reyrg2021/rover-ua/entregables/Rover UA · Temuco 2026.pptx

## Vehículo autónomo con evasión de obstáculos

GUÍA PARA EL EQUIPO · CONGRESO TEMUCO 2026

Cómo funciona el auto, cómo se calibra y cómo se prueba para obtener los datos que prometimos en el resumen.

IV Congreso de Ingeniería Aplicada a la Industria Sustentable

Universidad Autónoma de Chile · Sede Temuco · 21 y 22 de octubre de 2026

Facultad de Ingeniería · Sede Santiago

Notes: Esta guía es para el equipo: explica el auto completo, versión reactiva (la del resumen) y versión con barrido (la mejora), y el protocolo de pruebas para llenar los datos que faltan en el resumen. Léanla entera antes de la próxima sesión de pruebas.

## Qué prometimos y qué datos faltan

LO QUE DICE EL RESUMEN ENVIADO

Lo que ya está escrito

- Vehículo a escala, bajo costo, de estudiantes de primer año
- ESP32 + L298N + 2 motores DC + servo de dirección + 3 HC-SR04
- Máquina de estados con tres zonas por distancia frontal
- Crítica: retrocede y avanza en arco "como al estacionar"
- Histéresis de 5 cm para no oscilar entre zonas

Lo que hay que medir (corchetes del resumen)

- [N] recorridos de un circuito de [X] m con [N] obstáculos
- [X] % de recorridos completados sin colisiones
- Tiempo promedio [X ± Y] segundos
- Costo de materiales [$X] CLP
- Dónde se concentraron las colisiones

El resumen describe la versión reactiva. Esa es la que se evalúa primero. El barrido y las demás mejoras se presentan como trabajo adicional, con sus propios datos.

Rover UA · Temuco 2026

2

Notes: Los corchetes del resumen son compromisos. Todo lo que sigue sirve para llenarlos con datos reales, no estimados.

## Arquitectura del hardware

CONSTRUCCIÓN

Cerebro

ESP32 sobre shield con regulador. Lee sensores, decide, mueve motores y servos, y sirve la página WiFi.

Tracción

Puente H L298N y dos motores DC traseros. Motor A = rueda derecha, motor B = rueda izquierda. PWM a 1 kHz.

Dirección

Servo estándar sobre las ruedas delanteras. Centro 100°, recorrido útil 78° a 117° (±17°).

Percepción

Tres HC-SR04: dos laterales fijos a ~45° y uno central montado sobre un micro servo que puede barrer ±45°.

Energía

Cuatro 18650 de 2600 mAh en dos packs de 7,4 V: uno para el L298N y motores, otro para el shield del ESP32.

Interfaz

El ESP32 crea su propia red WiFi. Un celular muestra sensores, mapa, cronómetro y botones de inicio y pausa.

Rover UA · Temuco 2026

3

Notes: Seis bloques. Cada estudiante debería poder explicar cualquiera de los seis en un minuto, con el auto en la mano.

## Mapa de conexiones del ESP32

CONSTRUCCIÓN

Elemento | Señal | GPIO
Motor A (derecha) | ENA · IN1 · IN2 | 25 · 26 · 27
Motor B (izquierda) | ENB · IN3 · IN4 | 33 · 32 · 19
Servo de dirección | señal | 18
Servo de barrido | señal | 23
HC-SR04 derecho | Trig · Echo | 17 · 12
HC-SR04 central (sobre servo) | Trig · Echo | 16 · 4
HC-SR04 izquierdo | Trig · Echo | 21 · 22

Reglas que no se negocian

- GND del L298N unido al GND del ESP32: sin tierra común nada funciona
- Jumper 5V-EN del L298N puesto; jumpers de ENA y ENB quitados
- Echo de cada sensor pasa por divisor resistivo: 5 V al sensor, 3,3 V al ESP32
- GPIO 12 es pin de arranque: si el auto no enciende, mover ese Echo a 34, 35, 36 o 39
- Cables del sensor móvil con holgura y asegurados: es el que más se suelta

Rover UA · Temuco 2026

4

Notes: Impriman esta tabla y péguenla dentro de la caja del auto. En Temuco, lo que falla es un cable.

## Alimentación: dos packs, una tierra

CONSTRUCCIÓN

Pack 1 · 7,4 V

Entra al L298N (bornes 12V y GND). Alimenta los motores. Su regulador interno de 5 V alimenta la lógica del puente.

El L298N pierde 2 a 3 V: los motores ven ~5 V. Por eso el PWM mínimo útil es 125.

Pack 2 · 7,4 V

Entra al jack del shield. El regulador del shield da 5 V al ESP32, a los tres sensores y al servo de barrido.

El WiFi tiene picos de 400 mA. Si el ESP32 se reinicia, el registro dice "reset 9": brownout.

Riesgo monitoreado

El servo de dirección se alimenta del 5 V del L298N, un regulador de 0,5 A (el disipador del módulo enfría el puente, no el regulador). Un servo bloqueado pide 1 a 2 A y haría caer ese 5 V.

Por qué hoy no pasa: los topes por software (78°–117°) impiden que el servo fuerce el tope mecánico. En las pruebas no ha habido reinicios. Si el registro muestra "reset 9", alimentar los servos aparte.

Antes de cada recorrido: medir ambos packs. Menos de 7,0 V = cambiar pilas. Bajo 6,8 V el regulador del L298N deja de dar 5 V y el auto "se vuelve loco" sin que nada esté roto.

Rover UA · Temuco 2026

5

Notes: Si el jurado pregunta por qué dos packs: separar el ruido de los motores del microcontrolador. Si pregunta por el servo: explicar que el tope por software mantiene al servo fuera de la zona de bloqueo y que el registro de reinicios es la evidencia de que alcanza.

## Cómo mide un HC-SR04 y qué puede fallar

CÓMO DECIDE · PERCEPCIÓN

La medición

1. El ESP32 pone Trig en alto 10 µs
2. El sensor emite 8 pulsos a 40 kHz
3. Echo queda en alto hasta que vuelve el eco
4. distancia = tiempo × 0,0343 / 2 (cm)
5. Sin eco en 30 ms (más de 5 m): el código devuelve 999

Cómo lo usamos

- Tres lecturas por vuelta: izquierdo, central, derecho, con 40 ms entre ellas para que el eco de uno no entre en el otro
- En el barrido, mediana de 3 lecturas por ángulo
- 999 nunca se trata como "libre a toda velocidad": el auto baja a velocidad de precaución
- Laterales fijos a ~45°; central sobre el servo, mirando al frente mientras anda

Lo que el sensor no ve

- Superficies oblicuas: el eco rebota hacia otro lado
- Tela, espuma, cortinas: absorben el ultrasonido
- Objetos más bajos que el sensor o más angostos que el haz
- Menos de 2 cm: lectura inválida

Obstáculos de prueba: cajas de cartón rígidas, de al menos 25 cm de alto y 20 cm de ancho.

Rover UA · Temuco 2026

6

Notes: El resumen ya anticipa que las colisiones se concentran en obstáculos oblicuos o laterales. Esta lámina explica por qué: es física del sensor, no un error del código.

## Tres zonas según la distancia frontal

CÓMO DECIDE · MÁQUINA DE ESTADOS

LIBRE · MÁS DE 50 CM

Avanza a 200

Rumbo proporcional con los laterales si alguno está a menos de 60 cm. Si ninguno, recto.

PRECAUCIÓN · 25 A 50 CM

Baja a 145

La velocidad baja linealmente con la distancia. Mismo control de rumbo, con la rueda interior frenada.

CRÍTICA · 25 CM O MENOS

Se detiene y evade

Elige un lado (laterales o barrido) y ejecuta la maniobra en lazo cerrado.

Histéresis de 5 cm

Para salir de una zona hacia una más relajada hay que superar el umbral en 5 cm: de crítica a precaución recién a 30 cm, de precaución a libre recién a 55 cm. Sin esto, a 50 cm el auto alternaría entre dos velocidades diez veces por segundo.

Por qué 25 y 50 y no 20 y 40

Una vuelta del bucle toma hasta 250 ms (tres sensores). A velocidad normal el auto avanza ~8 cm entre lecturas. Con 20 cm llegaba a la pared antes de reaccionar. En el congreso, digan los valores que efectivamente usaron en las pruebas.

Rover UA · Temuco 2026

7

Notes: Este es el corazón del resumen. Que cualquiera del equipo pueda dibujar las tres zonas y explicar la histéresis con un ejemplo numérico.

## Control proporcional de rumbo con los laterales

CÓMO DECIDE · ZONAS LIBRE Y PRECAUCIÓN

LA REGLA, EN UNA LÍNEA

desvío = 0,35 × (dDerecha − dIzquierda)

en grados de servo, recortado a ±17°. Positivo = girar a la derecha. Los 999 se recortan a 100 cm. Solo actúa si algún lateral está a menos de 60 cm; en espacio abierto el auto va recto.

Ejemplo: pared a 20 cm a la izquierda, nada a la derecha: 0,35 × (100 − 20) = 28 → recortado a 17° a la derecha.

Tracción diferencial

Mientras el servo gira, la rueda trasera del lado interior se frena en proporción al desvío (hasta un 45 % de la exterior). El auto gira más cerrado de lo que el servo solo permite.

Velocidad según el frente

200 con más de 50 cm libres; baja en línea recta hasta 145 a 25 cm. 125 es el PWM mínimo que mueve el auto cargado, por eso 145 y no menos.

Qué resolvió

Antes el auto quedaba pegado a la pared: el sensor central veía libre y la corrección era de dos niveles. Ahora se aleja de forma continua del lado más cercano.

Rover UA · Temuco 2026

8

Notes: Es un controlador P, el más simple que existe. Si el jurado pregunta por PID: no hay término integral ni derivativo porque la planta es lenta y el sensor ruidoso; con P y la histéresis basta y es explicable por estudiantes de primer año.

## Dirección: lo que el servo puede y lo que no

CÓMO DECIDE · ACTUACIÓN

Posición | Servo | Rueda interior
Derecha fuerte | 78° | detenida
Derecha suave | 89° | 45 %
Centro (avanza recto) | 100° | 100 %
Izquierda suave | 110° | 45 %
Izquierda fuerte | 117° | detenida
Pivote (solo en evasión) | fuerte | reversa a fondo

Límite físico

Topes medidos: 75° y 120°. Con ±17° útiles el radio de giro con el servo solo es de 60 a 80 cm. Un rincón más chico que eso no se puede salir girando hacia adelante: solo pivotando.

Tope por software

Toda escritura al servo pasa por una sola función que recorta a 78°–117°. Aunque la lógica pida otra cosa, el servo nunca fuerza el tope mecánico (y nunca pide 2 A al regulador).

Si se desmonta el brazo

Repetir la calibración con calibracion_servos.ino: centrar a 90° eléctrico, montar con ruedas rectas, buscar topes de 5 en 5, anotar centro y topes en el código.

Rover UA · Temuco 2026

9

Notes: Mayor ángulo = izquierda en este auto. Esta es una decisión de diseño que conviene reconocer en la presentación: el varillaje da poco recorrido, y la tracción diferencial lo compensa.

## Maniobra de evasión en lazo cerrado

CÓMO DECIDE · ZONA CRÍTICA

1 · Detener y elegir lado

Reactiva: el lateral más lejano. Barrido: el hueco más ancho del mapa.

2 · Retroceder orientando

Ruedas al lado opuesto, cola frenada, hasta ver ≥ 45 cm al frente (tope 1,5 s).

3 · Avanzar en arco

Ruedas al lado elegido, interior detenida, hasta ver ≥ 60 cm (tope 1,5 s; corta si se acerca a otro obstáculo).

4 · ¿Frente libre?

Más de 30 cm: sigue en modo normal. Si no, siguiente intento.

Intento 2 · pivote

Dirección fuerte hacia el lado elegido, rueda interior en reversa a fondo y exterior adelante durante 900 ms: gira casi sobre su eje. Es la única salida de un rincón.

Intento 3 · el otro lado

Retrocede recto hasta ver 45 cm y pivota hacia el lado contrario. Si tampoco despeja, se declara atrapado, se detiene y avisa en la página.

Por qué "lazo cerrado"

La versión del resumen retrocedía y avanzaba tiempos fijos sin mirar. Ahora cada paso termina cuando el sensor dice que terminó. Es la diferencia entre un reloj y un controlador.

Rover UA · Temuco 2026

10

Notes: Al retroceder con las ruedas giradas hacia un lado, la trompa gira hacia el contrario, como al estacionar. Por eso para salir hacia la izquierda se retrocede con las ruedas a la derecha. Ensayen explicarlo con el auto en la mano.

## Barrido ultrasónico: un mapa local antes de salir

CÓMO DECIDE · VERSIÓN 2 (MEJORA)

Qué hace al entrar en crítica

1. Se detiene
2. El servo lleva el sensor central de 45° a 135°, de 15 en 15: siete lecturas (mediana de 3 cada una)
3. Lee los laterales y los combina con la celda de ±45° tomando el mínimo
4. Busca el hueco más ancho: lecturas seguidas con más de 50 cm
5. El centro del hueco define el lado; la maniobra es la misma de lazo cerrado

"¿Para qué barrer si tienen tres sensores?"

Tres sensores fijos dan tres puntos y no distinguen un hueco de 20 cm de uno de 1 m. Siete lecturas a 15° dentro del cono por donde el auto puede salir sí lo hacen. Los laterales se suman para cubrir las esquinas, donde el sensor central tiene punto ciego a corta distancia.

Por qué ±45° y no 0–180°

Más allá de 45° el sensor apunta a los soportes de los laterales, y el auto no puede salir hacia 80° sin maniobra de todas formas. Menos lecturas, menos tiempo detenido, sin lecturas basura.

Costo

Un barrido toma ~1,5 s con el auto detenido. Es el precio de decidir mejor; el tiempo de recorrido lo refleja y por eso se compara con la versión 1.

Rover UA · Temuco 2026

11

Notes: La pregunta del cuadro azul es la que va a hacer el jurado. La respuesta está lista.

## Telemetría y control desde el celular

CÓMO DECIDE · INTERFAZ

Conexión

Red WiFi: RoverUA
Clave: roverua2026
Página: http://192.168.4.1

El ESP32 es el punto de acceso: no necesita internet ni router. Funciona igual en Temuco que en el laboratorio.

Rover UA · Temuco 2026

Sensores en vivo

Izquierdo, central y derecho, la zona en color, velocidad y ángulo de dirección.

Mapa del barrido

Papel milimetrado con las siete lecturas, el hueco elegido en amarillo y la flecha de salida.

Cronómetro y contadores

Tiempo de corrida (no cuenta las pausas), evasiones, barridos y atrapamientos. Son los datos de la planilla.

Registro de eventos

Cambios de zona con la distancia, intentos de evasión y su resultado, motivo del último reinicio.

Iniciar · Pausar · Reanudar

Pausar detiene de inmediato, incluso en medio de una maniobra. No reemplaza al interruptor físico.

Calibración

Botones para posicionar el sensor y la dirección con el auto en pausa.

12

Notes: Al pausar, el ESP32 imprime la línea CORRIDA con tiempo, evasiones, barridos y atrapamientos. Esa línea es la fila de la planilla.

## Una vuelta del bucle principal

CÓMO DECIDE · RESUMEN

Leer

Izq, centro, der con 40 ms entre ellos. Hasta 210 ms si no hay ecos.

Clasificar

Zona con histéresis a partir de la distancia central.

Decidir

Crítica: evasión. Si no: desvío proporcional y velocidad según el frente.

Actuar

Servo de dirección y PWM a cada rueda, con la interior frenada si gira.

Atender

Página WiFi y telemetría, 50 ms de espera, y vuelta a leer.

4 a 8 Hz

Frecuencia real del bucle. El límite lo pone el tiempo de vuelo del ultrasonido, no el ESP32.

~8 cm

Lo que avanza el auto entre dos lecturas a velocidad normal. Por eso la zona crítica empieza a 25 cm.

0 hilos

Todo corre en un solo bucle; las esperas atienden la página, así "Pausar" responde siempre.

Rover UA · Temuco 2026

13

Notes: Percepción, decisión, actuación: las tres palabras del resumen, en una vuelta del bucle.

## La pista: el circuito de [X] m con [N] obstáculos

CÓMO SE PRUEBA · 1 DE 4

Propuesta concreta

- Rectángulo de 4 × 2 m en piso liso (baldosa o cerámica), delimitado con cinta
- Partida y meta marcadas en los lados cortos: recorrido nominal de 4 m
- Tres cajas de cartón de 30 × 30 × 30 cm, separadas al menos 1 m entre sí y 80 cm de las paredes
- Una caja centrada, las otras dos desplazadas a lados opuestos: obliga a dos evasiones y a un cambio de lado
- Mismas posiciones para todas las corridas; fotografiar la pista y marcar las cajas con cinta en el piso

Restricciones que vienen del auto

- Pasillos de 80 cm o más: radio de giro
- Nada de rincones ni callejones sin salida
- Obstáculos rígidos, altos y de frente plano
- Sin alfombras: las ruedas delanteras arrastran al pivotar

Recorrido completado

El auto cruza la línea de meta por sus propios medios. Si se declara atrapado, se pausa o alguien lo toca, el recorrido cuenta como no completado.

Rover UA · Temuco 2026

14

Notes: La pista es parte del método: si cambia entre corridas, los números no se pueden comparar. Decidan la pista una vez, fotografíenla y no la toquen más.

## Procedimiento de cada recorrido

CÓMO SE PRUEBA · 2 DE 4

Antes

- Medir los dos packs: 7,0 V o más
- Auto en la partida, centrado, mirando a la meta
- Celular conectado, página abierta, sensores en vivo con valores razonables
- Cajas en sus marcas
- Anotar número de corrida, versión y voltajes

Durante

- "Iniciar corrida": arranca el cronómetro
- Un observador cuenta colisiones (contacto físico con caja o borde) y en qué obstáculo
- Otro graba en video desde arriba
- Nadie toca el auto ni las cajas
- Si queda atrapado o sale de la pista: "Pausar" y anotar el motivo

Después

- Al cruzar la meta: "Pausar" de inmediato
- Copiar de la página: tiempo, evasiones, barridos, atrapamientos
- Completar la fila de la planilla
- Reponer las cajas si se movieron
- Cada 5 corridas: volver a medir los packs

Regla de oro: una corrida que no se anotó no existió. Y una corrida "mala" se anota igual: el porcentaje sin colisiones solo vale si incluye todas.

Rover UA · Temuco 2026

15

Notes: Tres roles: operador del celular, observador que anota, camarógrafo. Rotar los roles entre corridas para que todos sepan hacer todo.

## La planilla y cómo se calculan los números del resumen

CÓMO SE PRUEBA · 3 DE 4

N° | Versión | V pack 1 / 2 | Tiempo (s) | Evasiones | Barridos | Colisiones | Completado | Dónde chocó / notas
1 | v1 | 8,1 / 8,0 | 23,4 | 2 | 0 | 0 | sí | —
2 | v1 | 8,0 / 8,0 | 31,0 | 3 | 0 | 1 | sí | caja 2, lateral
3 | v2 | 7,9 / 8,0 | 35,2 | 2 | 2 | 0 | sí | —
… | | | | | | | | (filas de ejemplo, no datos reales)

[X] % sin colisiones

Corridas con 0 colisiones ÷ total de corridas × 100. Incluir las no completadas en el total.

[X ± Y] s

Promedio ± desviación estándar del tiempo, solo de las corridas completadas. Decir cuántas fueron.

Dónde chocó

Tabla de colisiones por obstáculo y por tipo (frontal, lateral, oblicuo). Confirma o corrige la frase del resumen.

Evasiones por corrida

Promedio. Si es mucho mayor que el número de cajas, el auto está evadiendo fantasmas: revisar sensores.

Rover UA · Temuco 2026

16

Notes: Las filas de la tabla son un ejemplo del formato, no datos. La planilla real va en el repositorio como CSV, y de ahí salen las cifras del resumen y un gráfico para la presentación.

## Cuántas corridas y en qué orden

CÓMO SE PRUEBA · 4 DE 4

10 + 10

Al menos diez corridas por versión. Con menos, un solo choque mueve el porcentaje 20 puntos y no se puede decir nada.

v1 · v2 · v1 · v2

Alternar versiones en bloques de 5 (solo cambia MODO_BARRIDO). Así el desgaste de las pilas y el calentamiento afectan a las dos por igual.

1 sesión

Veinte corridas de medio minuto más la preparación caben en dos horas. Hacerlas el mismo día, en la misma pista, con las mismas pilas.

Qué se puede afirmar y qué no

Con 10 corridas por versión se puede decir "v2 completó 9 de 10 y v1 6 de 10". No se puede decir que la diferencia es estadísticamente significativa sin un test; es honesto presentarlo como tendencia y decir el n.

Antes de la sesión de datos

Una sesión de ajuste aparte (no se anota): KP_RUMBO, T_PIVOTE, umbrales. Cuando el auto complete 3 corridas seguidas sin tocar nada, se congela el código, se anota la versión y recién ahí empiezan las corridas que cuentan.

Rover UA · Temuco 2026

17

Notes: Separar ajuste de medición es lo que distingue un experimento de una demostración. Si durante las corridas que cuentan cambian un parámetro, las anteriores se descartan.

## Costo de materiales: [$X] CLP

DATO PENDIENTE DEL RESUMEN

Componente | Cant. | Precio pagado (CLP)
ESP32 DevKit + shield | 1 | [$____]
Puente H L298N | 1 | [$____]
Chasis, motores DC y ruedas | 1 | [$____]
Servo de dirección | 1 | [$____]
Micro servo de barrido + soporte | 1 | [$____]
Sensores HC-SR04 | 3 | [$____]
Baterías 18650 + portapilas + cargador | 4 | [$____]
Cables, resistencias, buck, interruptores | — | [$____]
Total | | [$____]

Cómo llenarla

Precio realmente pagado, con boleta o captura de la tienda. Si algo fue prestado por la universidad, igual se pone su precio de mercado y se indica con una nota.

Por qué importa

"Bajo costo" está en el título. El jurado va a comparar con un kit comercial o un robot educativo; tengan ese número de referencia a mano.

Rover UA · Temuco 2026

18

Notes: Un estudiante se encarga de esta tabla esta semana. Es la cifra más fácil de conseguir y la más fácil de olvidar.

## Mejoras implementadas después del resumen

QUÉ CONTAR EN TEMUCO

Mejora | Problema que resolvió | Cómo se demuestra
Tracción diferencial | El servo gira solo ±17°; el auto no alcanzaba a esquivar | Rueda interior frenada o invertida en cada giro; radio de giro visiblemente menor
Control proporcional de rumbo | Quedaba pegado a la pared cuando el frente estaba libre | Se aleja del lado cercano de forma continua; sin zigzag
Evasión en lazo cerrado | Tiempos fijos: a veces poco, a veces de más | Cada paso termina cuando el sensor ve libre; pivote si no sale
Barrido + mapa local (v2) | Tres puntos no distinguen huecos anchos de angostos | Mapa en el celular con el hueco elegido; comparación v1/v2 con datos
Telemetría WiFi y registro | Imposible diagnosticar en el piso sin cable | Sensores en vivo, zona, eventos y motivo de reinicio desde el celular
Calibración documentada | Servos sin centro, topes forzados, reinicios | Procedimiento repetible y valores en el código con fecha

Narrativa sugerida: "el resumen describe la primera versión; al probarla encontramos tres límites (giro, pared, maniobra ciega) y los resolvimos así". Un problema encontrado y resuelto vale más ante un jurado que un sistema que "siempre funcionó".

Rover UA · Temuco 2026

19

Notes: Cada fila es una lámina posible de la presentación del congreso: problema, solución, evidencia.

## Limitaciones conocidas, dichas antes de que las pregunten

QUÉ CONTAR EN TEMUCO

Radio de giro

±17° de servo. Compensado con tracción diferencial y pivote, pero un rincón menor a 60 cm sigue siendo una trampa. Mejora futura: varillaje con más recorrido.

Obstáculos oblicuos o blandos

El ultrasonido rebota lejos de superficies inclinadas y se pierde en tela. Es la causa esperada de las colisiones. Mejora futura: sensor de tiempo de vuelo infrarrojo o cámara.

Sin memoria del entorno

Decide solo con lo que ve ahora. No sabe dónde estuvo ni hacia dónde va la meta. Por eso el resumen propone odometría y mapeo como trabajo futuro.

Alimentación

El servo de dirección sobre el regulador del L298N. Hoy basta con los topes por software y pilas sobre 7,0 V; el registro de reinicios vigila que siga bastando. Mejora futura: fuente dedicada para servos.

Rover UA · Temuco 2026

Velocidad del bucle

4 a 8 lecturas por segundo limitan la velocidad segura a unos 30 cm/s. Un AGV real usa LiDAR a 10 Hz o más; la escala y el costo explican la diferencia.

Sin parada de emergencia física

La pausa es por WiFi. En un AGV industrial es obligatoria una seta de emergencia cableada. Un interruptor en el pack de motores es la versión a escala.

20

Notes: Decir las limitaciones primero quita al jurado la oportunidad de "descubrirlas" y muestra que el equipo entiende el sistema. Cada limitación viene con su mejora futura.

## Preguntas probables del jurado

QUÉ CONTAR EN TEMUCO

Pregunta | Respuesta corta (y quién la responde)
¿Por qué ultrasonido y no LiDAR o cámara? | Costo y simplicidad para primer año: tres sensores cuestan menos que un cable de LiDAR. Mostramos sus límites y los medimos. [nombre]
¿Qué pasa si falla un sensor? | "Sin eco" se trata como incertidumbre: baja la velocidad, nunca acelera. El registro lo muestra. [nombre]
¿Cómo elige hacia dónde evadir? | v1: el lateral más lejano. v2: el hueco más ancho de siete lecturas más los laterales. La maniobra es la misma. [nombre]
¿Por qué retrocede con las ruedas hacia el otro lado? | Como al estacionar: en reversa la trompa gira al contrario de las ruedas. Demostrarlo con el auto en la mano. [nombre]
¿Es un controlador PID? | Es proporcional. No hay integral ni derivativo porque el sensor es ruidoso y lento; con P e histéresis basta y se explica en una pizarra. [nombre]
¿Cuántas corridas y qué variabilidad? | n por versión, promedio y desviación, y la tabla de dónde chocó. Decir qué no se puede afirmar con ese n. [nombre]
¿Qué relación tiene con Industria 4.0? | Un AGV a escala: percepción, decisión, actuación y telemetría inalámbrica son las mismas capas de uno real. [nombre]
¿Qué harían con más tiempo? | Varillaje con más giro, odometría con encoders, mapeo acumulado, sensor ToF para oblicuos, fuente dedicada para servos. [nombre]

Rover UA · Temuco 2026

21

Notes: Asignar cada pregunta a un estudiante y ensayar las respuestas en voz alta, con cronómetro: 30 segundos cada una.

## Lista para el día de la demostración

QUÉ CONTAR EN TEMUCO

Esta semana

- Prueba de carga con el registro abierto: ningún "reset 9"
- Interruptor en cada pack
- Cables del sensor móvil asegurados con silicona
- Sesión de ajuste y luego sesión de datos (20 corridas)
- Tabla de costos completa
- Código congelado y subido al repositorio con la versión

En la maleta

- 8 pilas 18650 cargadas (dos juegos) y el cargador
- Sensor HC-SR04, servo SG90 y L298N de repuesto
- Cables Dupont, cinta, silicona caliente, destornilladores
- Multímetro
- Notebook con Arduino IDE y el código final cargado
- Tres cajas plegables para la pista y cinta de piso

En el stand

- Medir packs antes de cada demostración
- Celular conectado a la red del auto antes de que llegue el jurado
- Video de respaldo de una corrida completa, por si el piso o el espacio no sirven
- Planilla impresa con los resultados
- Pista mínima armada: 2 cajas, 2 m
- Un estudiante en el celular, uno explica, uno cuida el auto

Rover UA · Temuco 2026

22

Notes: El video de respaldo no es opcional: en un congreso el piso puede ser alfombra y el espacio un pasillo. Si la demo en vivo no se puede hacer, el video más la telemetría en el celular mantienen la presentación.

## Lo que el jurado tiene que irse sabiendo

PARA CERRAR

1

Estudiantes de primer año integraron percepción, decisión y actuación en un sistema que se mueve solo.

2

Lo midieron: n corridas, porcentaje sin colisiones, tiempo con su variabilidad, dónde falla y por qué.

3

Encontraron límites reales y los resolvieron con ingeniería: tracción diferencial, control proporcional, lazo cerrado, mapa local.

Próximo paso del equipo: sesión de ajuste, sesión de datos, tabla de costos, repositorio y ensayo de la presentación con cronómetro.

Universidad Autónoma de Chile · Facultad de Ingeniería

Notes: Cierre. Las tres ideas de esta lámina son las tres frases con que debería terminar la presentación en Temuco.
