reyrg2021/rover-ua/docs/resumen-congreso/Resumen_Temuco2026_VehiculoAutonomo_v2.docx

IV Congreso de Ingeniería Aplicada a la Industria Sustentable

Universidad Autónoma de Chile – Sede Temuco

21 y 22 de octubre de 2026

Vehículo autónomo de bajo costo con evasión reactiva de obstáculos: prototipo a escala para intralogística en Industria 4.0

Autores: [Nombre Apellido Apellido (estudiante que presenta)], [Nombre Apellido Apellido], [Nombre Apellido Apellido], [Nombre Apellido Apellido], Reinier Rodríguez Guillén

Afiliación(es): Facultad de Ingeniería, Universidad Autónoma de Chile, Sede Santiago, Chile

Correo Electrónico:

Palabras Clave: robótica móvil, evasión de obstáculos, sensores ultrasónicos, ESP32, Industria 4.0

Resumen

Los vehículos de guiado automático (AGV) y robots móviles autónomos (AMR) son centrales en la intralogística de la Industria 4.0, y evitar obstáculos es una de sus funciones de seguridad básicas. El objetivo fue diseñar, construir y evaluar un vehículo autónomo a escala, de bajo costo, que se desplace evitando obstáculos sin intervención humana, desarrollado por estudiantes de primer año de ingeniería. Integra un ESP32, dos motores DC de tracción con un puente H L298N, dirección por servomotor y tres sensores ultrasónicos (frontal y laterales). El control, programado en C++ (Arduino), es una máquina de estados reactiva con tres zonas según la distancia frontal: libre (>40 cm); precaución (20–40 cm), donde reduce la velocidad y corrige el rumbo con los sensores laterales; y crítica (≤20 cm), donde retrocede y avanza en arco con la dirección girada, como al estacionar, eligiendo el lado según las distancias laterales. Una histéresis de 5 cm evita oscilaciones entre zonas. El desempeño se evaluó en [N] recorridos de un circuito de [X] m con [N] obstáculos, registrando colisiones, maniobras de evasión y tiempo. El vehículo completó el [X] % de los recorridos sin colisiones, con un tiempo promedio de [X ± Y] s y un costo de materiales de [$X] CLP. [Las colisiones se concentraron en obstáculos oblicuos o laterales, que el sensor frontal no detecta.] Se concluye que estudiantes de primer año pueden integrar percepción, decisión y actuación en un sistema autónomo funcional, y que el prototipo es una base escalable para incorporar odometría, telemetría inalámbrica y mapeo del entorno.

Envío del Resumen

Por favor, envíe este formulario completo al correo:

Subirlo por la página web

📅 Fecha límite de envío: 05 de octubre de 2026
